ThoMint/modFOC/README.md

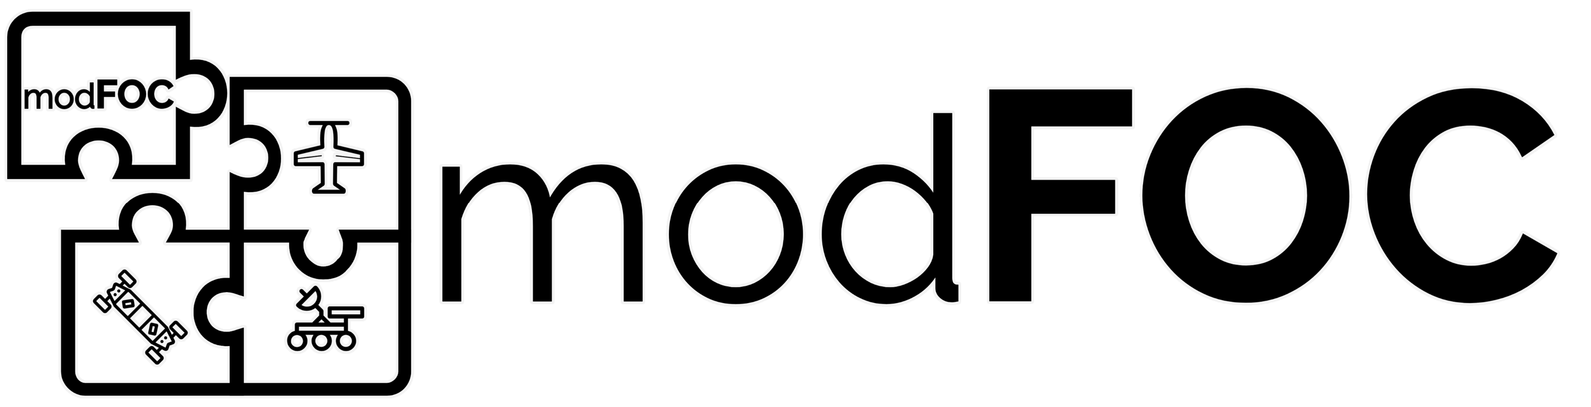
[picture p1: PR/modFOC-Logo-Landscape-Outline.png]
modFOC
# 
A modular ESC with in Hardware implemented FOC for maximum efficiency.<br>
The ESC is designed as a PCB-Stackup with various Powerstages and a central Control-Board:

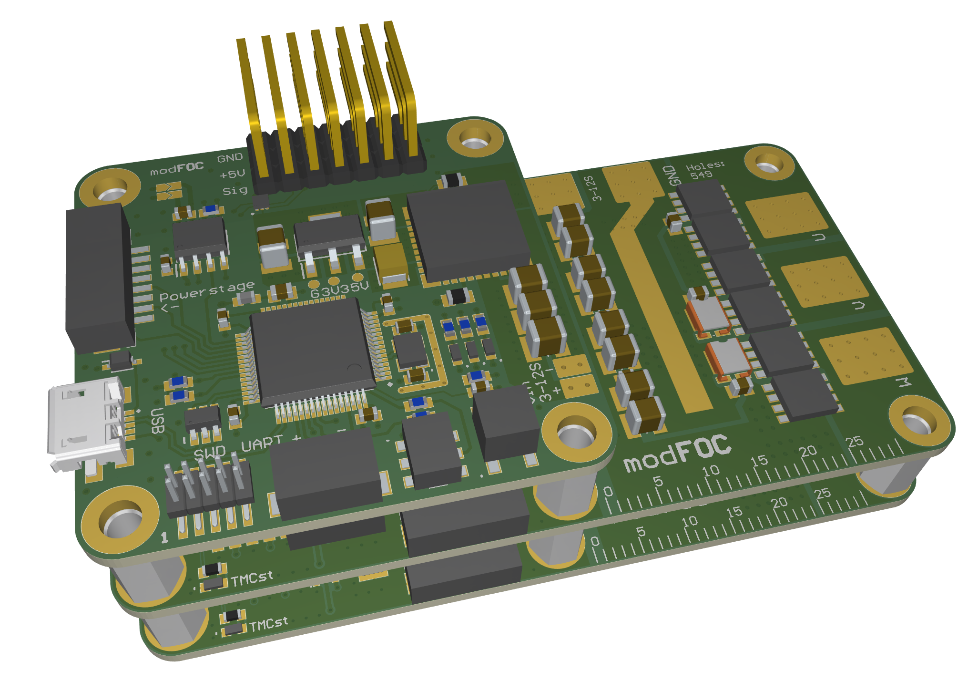
[picture p2: PR/MBA-3D-Render.png]
modFOC Render


As this Project advances, more and more Powerstages will be available supporting a variaty of Motors:
 - BLDC
 - Stepper
 - DC
