ThoMint/modFOC/DesignGuide/TMC4671Eval/BOM/BOM_TMC4671-EVAL_V1.2.xls

Sheet: Part List Report
 | BOM |  | BOM for Project [TMC4671-EVAL_V1_2.PrjPcb] (No PCB Document Selected)
 | Project: | TMC4671-EVAL
 | Version: | 1.2
 | Date: | 2019-09-04
# | Quantity | MPN | Comment | Designator | FootPrint | Description | Note | MF
1 | 14 | MC0603B104K100CT | 100nF/10V | C200, C201, C320, C321, C322, C323, C601, C602, C604, C605, C606, C607, C608, C610 | C0603 | SMD Multilayer Ceramic Capacitor, 0603 [1608 Metric], 0.1 µF, 10 V, ± 10%, X7R, MC Series |  | Multicomp
2 | 5 | MC0603X105K100CT | 1uF/10V | C300, C301, C302, C303, C500 | C0603 | SMD Multilayer Ceramic Capacitor, 0603 [1608 Metric], 1 µF, 10 V, ± 10%, X5R, MC Series |  | MULTICOMP
3 | 11 | MC0603N101J500CT | 100pF/50V/5% | C304, C305, C306, C307, C308, C309, C501, C502, C503, C504, C505 | C0603 | SMD Multilayer Ceramic Capacitor, 0603 [1608 Metric], 100 pF, 50 V, ± 5%, C0G / NP0, MC Series |  | MULTICOMP
4 | 6 | MC0603B102K250CT | 1nF/25V | C310, C311, C314, C315, C318, C319 | C0603 | SMD Multilayer Ceramic Capacitor, 0603 [1608 Metric], 1000 pF, 25 V, ± 10%, X7R, MC Series |  | MULTICOMP
5 | 2 | MCMT18N101F100CT | 100pF/10V | C506, C507 | C0603 | SMD Multilayer Ceramic Capacitor, 0603 [1608 Metric], 100 pF, 10 V, ± 1%, C0G / NP0, MCMT Series |  | MULTICOMP
6 | 1 | MCSH18B103K100CT | 10nF | C508 | C0603 | SMD Multilayer Ceramic Capacitor, 0603 [1608 Metric], 0.01 µF, 10 V, ± 10%, X7R, MCSH Series |  | MULTICOMP
7 | 1 | EMK325ABJ107MM-T | 100uF/16V | C600 | C1210 | SMD Multilayer Ceramic Capacitor, 1210 [3225 Metric], 100 µF, 16 V, ± 20%, X5R, M Series |  | TAIYO YUDEN
8 | 2 | MC0603X475K100CT | 4u7/10V | C603, C609 | C0603 | SMD Multilayer Ceramic Capacitor, 0603 [1608 Metric], 4.7 µF, 10 V, ± 10%, X5R, MC Series |  | MULTICOMP
9 | 1 | GRM31CR60J107ME39L. | 100uF/6V3 | C611 | C1210 | SMD Multilayer Ceramic Capacitor, 1210 [3225 Metric], 100 µF, 6.3 V, ± 20%, X5R, GRM Series |  | MURATA
10 | 1 | GRM31CR61A476ME15L | 47uF/10V | C612 | C1206 | SMD Multilayer Ceramic Capacitor, 1206 [3216 Metric], 47 µF, 10 V, ± 20%, X5R, GRM Series |  | MURATA
11 | 1 | MC0603B104K100CT | 100nF | C613 | C0603 | SMD Multilayer Ceramic Capacitor, 0603 [1608 Metric], 0.1 µF, 10 V, ± 10%, X7R, MC Series |  | Multicomp
12 | 1 | MC0603X474K160CT | 470nF | C614 | C0603 | SMD Multilayer Ceramic Capacitor, 0603 [1608 Metric], 0.47 µF, 16 V, ± 10%, X5R, MC Series |  | Multicomp
13 | 1 | MC0603X475K100CT | 4u7 | C615 | C0603 | SMD Multilayer Ceramic Capacitor, 0603 [1608 Metric], 4.7 µF, 10 V, ± 10%, X5R, MC Series |  | MULTICOMP
14 | 7 | BAT54S | BAT54S | D200, D500, D501, D502, D503, D504, D505 | SOT95P237X130-3N | Small Signal Schottky Diode, Dual Series, 30 V, 200 mA, 1 V, 600 mA, 125 °C |  | TAIWAN SEMICONDUCTOR
15 | 1 | TMC4671 | TMC4671 | IC200 | QFN40P1050X650X90_HS-77N |  |  | TRINAMIC
16 | 1 | AT25128B-SSHL-T | AT25128B-SSHL-T | IC201 | SOP127P600X175-8N | EEPROM, SPI, 128 Kbit, 16K x 8bit, 20 MHz, SOIC, 8 Pins |  | MICROCHIP
17 | 4 | SN74LVC3G17DCUR | SN74LVC3G17DCUR | IC300, IC301, IC302, IC303 | TSSOP50P310X90-8L | Triple Schmitt-Trigger Buffer, 74LVC3G17, 1.65 V to 5.5 V, VSSOP-8 |  | TEXAS INSTRUMENTS
18 | 1 | LD1117S33CTR | LD1117S33CTR | IC600 | SOT230P700X180-4N | Fixed LDO Voltage Regulator, 4.75V to 15V, 1.1V Dropout, 3.3Vout, 950mAout, SOT-223-4 |  | STMICROELECTRONICS
19 | 1 | MFB-160808-0030PQ | 30R | L200 | L0603 | Ferrite Bead, 30 ohm, 0603 [1608 Metric], MFB Series, 3 A, 0.04 ohm, ± 25% |  | MEC MARCOM
20 | 2 | 46-3492-44-3-00-10-PPTR | Interface to UC/MC | P1, P2 | Interface_Connector | Board-To-Board Connector, 2.54 mm, 44 Contacts, Receptacle, HLE Series, Surface Mount, 2 Rows |  | W+P
21 | 1 |  | UART | P200 | TH_HDR_1X3 | Header, 3-Pin | Not fitted
22 | 1 | DF20F-10DP-1V(56) | DF20F-10DP-1V(56) | P201 | CON, TMC Debug SPI | Wire-To-Board Connector, 1 mm, 10 Contacts, Header, DF20 Series, Surface Mount, 2 Rows |  | Hirose Electric Co Ltd
23 | 1 |  | PWM_IN | P202 | TH_HDR_1X2 | Header, 2-Pin | Not fitted
24 | 1 |  | ENC1 | P300 | TH_HDR_1X5 | Header, 5-Pin
25 | 1 |  | ENC2 | P301 | TH_HDR_1X5 | Header, 5-Pin
26 | 1 |  | HALL | P302 | TH_HDR_1X5 | Header, 5-Pin
27 | 1 |  | REF_SW | P303 | TH_HDR_1X5 | Header, 5-Pin
28 | 1 |  | BRAKE_OUT | P400 | TH_HDR_1X2 | Header, 2-Pin
29 | 1 |  | AENC | P500 | TH_HDR_1X5 | Header, 5-Pin
30 | 1 |  | AIN_B | P501 | TH_HDR_1X2 | Header, 2-Pin
31 | 1 |  | AIN_A | P502 | TH_HDR_1X2 | Header, 2-Pin
32 | 11 | MC0063W0603110K | 10k | R200, R400, R401, R402, R403, R404, R405, R407, R408, R409, R410 | R0603 | SMD Chip Resistor, Thick Film, 10 kohm, 50 V, 0603 [1608 Metric], 63 mW, ± 1%, MC Series |  | MULTICOMP
33 | 8 | MCWR06X1001FTL, MC0063W060311K | 1k | R300, R301, R302, R303, R304, R305, R507, R508 | R0603 | SMD Chip Resistor, Thick Film, 1 kohm, 50 V, 0603 [1608 Metric], 100 mW, ± 1%, MCWR Series, SMD Chip Resistor, Thick Film, 1 kohm, 50 V, 0603 [1608 Metric], 100 mW, ± 0.5%, RE Series |  | MULTICOMP
34 | 18 | WR06X4701FTL | 4k7 | R306, R307, R308, R309, R310, R311, R312, R313, R314, R315, R316, R317, R318, R319, R320, R321, R322, R323 | R0603 | SMD Chip Resistor, 4.7 kohm, 75 V, 0603 [1608 Metric], 100 mW, ± 1%, WR06 Series |  | WALSIN
35 | 1 | MC0063W0603110K | 10R | R406 | R0603 | SMD Chip Resistor, Thick Film, 10 ohm, 50 V, 0603 [1608 Metric], 100 mW, ± 1%, MCWR Series |  | MULTICOMP
36 | 5 | MCWR06X1000FTL | 100R | R500, R501, R502, R503, R504 | R0603 | SMD Chip Resistor, Thick Film, 100 ohm, 50 V, 0603 [1608 Metric], 100 mW, ± 1%, MCWR Series |  | MULTICOMP
37 | 2 | CRCW08054K00FKTA | 4k | R505, R506 | R0805 | SMD Chip Resistor, Thick Film, 4 kohm, 150 V, 0805 [2012 Metric], 125 mW, ± 1%, CRCW Series |  | VISHAY
38 | 1 | MCWR06X1501FTL | 1k5 | R509 | R0603 | SMD Chip Resistor, Thick Film, 1.5 kohm, 50 V, 0603 [1608 Metric], 100 mW, ± 1%, MCWR Series |  | MULTICOMP
39 | 1 | MCWR06X1003FTL | 100k | R510 | R0603 | SMD Chip Resistor, Thick Film, 100 kohm, 50 V, 0603 [1608 Metric], 100 mW, ± 1%, MCWR Series |  | MULTICOMP
40 | 1 | FOX924B-25.000 | 25MHz | XTL200 | FOX924B-25.000 | TCXO, 25 MHz, 2.5 ppm, SMD, 5mm x 3.2mm, HCMOS, 3.3 V, FOX924 Series |  | FOX ELECTRONICS
Approved |  |  | Notes |  |  |  |  | 123

Sheet: Project Information
Project Full Path | C:\Users\UK\AppData\Local\TempReleases\Snapshot\10\TMC4671-EVAL_V1_2.PrjPcb
Project Filename | TMC4671-EVAL_V1_2.PrjPcb
Variant Name | None
Data-Source Filename | TMC4671-EVAL_V1_2.PrjPcb
Data-Source Full Path | C:\Users\UK\AppData\Local\TempReleases\Snapshot\10\TMC4671-EVAL_V1_2.PrjPcb
Title | BOM for Project [TMC4671-EVAL_V1_2.PrjPcb] (No PCB Document Selected)
Total Quantity | 123
Report Time | 15:44:00
Report Date | 2019-09-04
Report Date & Tine | 2019-09-04 15:44
Output Name | BOM
Output Type | BOM_PartType
Output Generator Name | BOM
Output Generator Description | Bill of Materials
