ThoMint/modFOC/DesignGuide/AlternatePartsModFOC.xlsx

Original Part Nr | Alternative Part Nr
TPH2R506PL | 757-TPH2R306NHL1Q
LB Q39G-L2OO-35-1 | LB Q39E-N1OO-35-1
CL32B106KMVNNWE | C3225X7R1N106M250AC
LS L29K-G1J2-1-Z | 150060RS75000
BAT54S | BAT54S-HF
CAS-D20A1 | Home-Stock
ERJ-6ENF4992V | CRCW080549K9FKEAC
MCT06030C1002FP500 | RT0603FRE0710KL (https://www.mouser.at/ProductDetail/Yageo/RT0603FRE0710KL?qs=8cPjvKtxWv43uywOotU9ew%3D%3D)
STM32G474RBT6 | Digikey
LG Q396-PS-35 | 150060GS75000 (https://www.mouser.at/ProductDetail/Wurth-Elektronik/150060GS75000?qs=LlUlMxKIyB0UYkq5lDO8nA%3D%3D)
AP2114H-3.3TRG1 | AP7361-33E-13 (https://www.mouser.at/ProductDetail/Diodes-Incorporated/AP7361-33E-13?qs=gfe7vQ8txpWtbSNeblwOwA%3D%3D)
BAS3010A03WE6327HTSA1 | CUS10S30,H3F (https://www.mouser.at/ProductDetail/Toshiba/CUS10S30H3F?qs=cW4DzVrAanO4Xm6ySrHr7g%3D%3D)
