ThoMint/modFOC/Hardware/modFOC-ESC/Project Outputs for modFOC/modFOC_BOM.xlsx

Quantity | Manufacturer_Part_Number | Mouser Part Number | Manufacturer_Name | Designator
1 | CL32B106KMVNNWE | 187-CL32B106KMVNNWE | Samsung Electro-Mechanics | C100
1 | CL32B106KMVNNWE | 187-CL32B106KMVNNWE | Samsung Electro-Mechanics | C101
1 | CL32B106KMVNNWE | 187-CL32B106KMVNNWE | Samsung Electro-Mechanics | C102
1 | VJ0603Y104JXJAC | 77-VJ0603Y104JXJAC | Vishay | C103
1 | VJ0603Y104JXJAC | 77-VJ0603Y104JXJAC | Vishay | C104
1 | VJ0603Y104JXJAC | 77-VJ0603Y104JXJAC | Vishay | C105
1 | VJ0603Y104JXJAC | 77-VJ0603Y104JXJAC | Vishay | C106
1 | VJ0603Y104JXJAC | 77-VJ0603Y104JXJAC | Vishay | C107
1 | VJ0603Y104JXJAC | 77-VJ0603Y104JXJAC | Vishay | C108
1 | VJ0603Y104JXJAC | 77-VJ0603Y104JXJAC | Vishay | C109
1 | VJ0603Y104JXJAC | 77-VJ0603Y104JXJAC | Vishay | C110
1 | VJ0603Y104JXJAC | 77-VJ0603Y104JXJAC | Vishay | C111
1 | CL32B106KMVNNWE | 187-CL32B106KMVNNWE | Samsung Electro-Mechanics | C112
1 | 08051C474KAT2A | 581-08051C474KAT2A | AVX | C113
1 | CL32B106KMVNNWE | 187-CL32B106KMVNNWE | Samsung Electro-Mechanics | C114
1 | VJ0603Y104JXJAC | 77-VJ0603Y104JXJAC | Vishay | C115
1 | VJ0603Y104JXJAC | 77-VJ0603Y104JXJAC | Vishay | C200
1 | GRM033R71E102KA01D | 81-GRM033R71E102KA1D | Murata Electronics | C201
1 | GRM033R71E102KA01D | 81-GRM033R71E102KA1D | Murata Electronics | C202
1 | GRM033R71E102KA01D | 81-GRM033R71E102KA1D | Murata Electronics | C203
1 | VJ0603Y104JXJAC | 77-VJ0603Y104JXJAC | Vishay | C205
1 | CL32B106KMVNNWE | 187-CL32B106KMVNNWE | Samsung Electro-Mechanics | C300
1 | CGA3E2X7R1H473K080AA | 810-CGA3E2X7R1H473K | TDK | C304
1 | CL32B106KMVNNWE | 187-CL32B106KMVNNWE | Samsung Electro-Mechanics | C305
1 | CL32B106KMVNNWE | 187-CL32B106KMVNNWE | Samsung Electro-Mechanics | C306
1 | VJ0603Y104JXJAC | 77-VJ0603Y104JXJAC | Vishay | C307
1 | VJ0603Y104JXJAC | 77-VJ0603Y104JXJAC | Vishay | C308
1 | CL32B106KMVNNWE | 187-CL32B106KMVNNWE | Samsung Electro-Mechanics | C309
1 | CL32B106KMVNNWE | 187-CL32B106KMVNNWE | Samsung Electro-Mechanics | C310
1 | CL32B106KMVNNWE | 187-CL32B106KMVNNWE | Samsung Electro-Mechanics | C?
1 | VJ0603Y104JXJAC | 77-VJ0603Y104JXJAC | Vishay | C?
1 | C0603C101K1HACTU | 80-C0603C101K1HACTU | Kemet | C?
1 | C0603C101K1HACTU | 80-C0603C101K1HACTU | Kemet | C?
1 | C0603C101K1HACTU | 80-C0603C101K1HACTU | Kemet | C?
1 | 08051C474KAT2A | 581-08051C474KAT2A | AVX | C?
1 | 08051C474KAT2A | 581-08051C474KAT2A | AVX | C?
1 | 08051C474KAT2A | 581-08051C474KAT2A | AVX | C?
1 | DF13A-8P-1.25H(21) | 798-DF13A8P125H21 | Hirose | CON101
1 | DF13A-4P-1.25H(51) | 798-DF13A4P125H51 | Hirose | CON102
1 | BAT54S | 583-BAT54S | Rectron | D200
1 | 74LVC138ABQ,115 | 771-LVC138ABQ115 | Nexperia | IC102
1 | AP2114H-3.3TRG1 | 621-AP2114H-3.3TRG1 | Diodes Inc. | IC103
1 | 74LVC3G17DP,125 | 771-LVC3G17DP125 | Nexperia | IC200
1 | DRV8323HRTAR | 595-DRV8323HRTAR | Texas Instruments | IC300
1 |  |  |  | IC 101
1 | DF13A-5P-1.25H(21) | 798-DF13A5P125H21 | Hirose | J200
1 |  |  |  | JP1
1 |  |  |  | JP2
1 |  |  |  | JP3
1 |  |  |  | JP4
1 |  |  |  | JP5
1 |  |  |  | JP6
1 |  |  |  | JP7
1 |  |  |  | JP8
1 | BLM18KG300TH1D | 81-BLM18KG300TH1D | Murata Electronics | L101
1 | ASMT-RA45-AP932 | 630-ASMT-RA45-AP932 | Avago Technologies | LED200
1 | LB Q39G-L2OO-35-1 | 720-LBQ39GL2N2351 | OSRAM | LED201
1 | LG Q396-PS-35 | 720-LGQ396A3964 | OSRAM | LED202
1 | LS L29K-G1J2-1-Z | 720-LSL29K-G1J2-1-Z | OSRAM | LED300
1 | TPH2R506PL,L1Q | 757-TPH2R506PLL1Q | Toshiba | Q300
1 | TPH2R506PL,L1Q | 757-TPH2R506PLL1Q | Toshiba | Q301
1 | TPH2R506PL,L1Q | 757-TPH2R506PLL1Q | Toshiba | Q302
1 | TPH2R506PL,L1Q | 757-TPH2R506PLL1Q | Toshiba | Q303
1 | TPH2R506PL,L1Q | 757-TPH2R506PLL1Q | Toshiba | Q304
1 | TPH2R506PL,L1Q | 757-TPH2R506PLL1Q | Toshiba | Q305
1 | RC0603FR-0710KL | 603-RC0603FR-0710KL | YAGEO (PHYCOMP) | R100
1 | RC0603FR-0710KL | 603-RC0603FR-0710KL | YAGEO (PHYCOMP) | R101
1 | CRCW0603100RFKEAC | 71-CRCW0603100RFKEAC | Vishay | R102
1 | CRCW06034K70JNEAC | 71-CRCW06034K70JNEAC | Vishay | R200
1 | CRCW06034K70JNEAC | 71-CRCW06034K70JNEAC | Vishay | R201
1 | CRCW06034K70JNEAC | 71-CRCW06034K70JNEAC | Vishay | R202
1 | SFR03EZPF1500 | 755-SFR03EZPF1500 | ROHM Semiconductor | R203
1 | CRCW0603100RFKEAC | 71-CRCW0603100RFKEAC | Vishay | R204
1 | CR0603-FX-47R0ELF | 652-CR0603FX-47R0ELF | Bourns | R205
1 | CRCW06034K70JNEAC | 71-CRCW06034K70JNEAC | Vishay | R206
1 | CRCW06034K70JNEAC | 71-CRCW06034K70JNEAC | Vishay | R207
1 | CRCW06034K70JNEAC | 71-CRCW06034K70JNEAC | Vishay | R208
1 | CRCW0603100RFKEAC | 71-CRCW0603100RFKEAC | Vishay | R209
1 | RC0603FR-0710KL | 603-RC0603FR-0710KL | YAGEO (PHYCOMP) | R210
1 | RC0603FR-0710KL | 603-RC0603FR-0710KL | YAGEO (PHYCOMP) | R211
1 | ERJ1GNF1003C |  | Panasonic | R212
1 | ERJ1GNF1501C |  | Panasonic | R213
1 | CRCW0603100RFKEAC | 71-CRCW0603100RFKEAC | Vishay | R214
1 | RC0603FR-0710KL | 603-RC0603FR-0710KL | YAGEO (PHYCOMP) | R215
1 | RC0603FR-0710KL | 603-RC0603FR-0710KL | YAGEO (PHYCOMP) | R216
1 | RC0603FR-071ML | 603-RC0603FR-071ML | YAGEO (PHYCOMP) | R300
1 | RC0603FR-0710KL | 603-RC0603FR-0710KL | YAGEO (PHYCOMP) | R303
1 | RC0603FR-0710KL | 603-RC0603FR-0710KL | YAGEO (PHYCOMP) | R304
1 | CRCW0603100RFKEAC | 71-CRCW0603100RFKEAC | Vishay | R305
1 | CRCW0603100RFKEAC | 71-CRCW0603100RFKEAC | Vishay | R306
1 | RC0603FR-10470RL | 603-RC0603FR-10470RL | YAGEO (PHYCOMP) | R307
1 | WSK1216L5000FEA |  | Vishay | R?
1 | WSK1216L5000FEA |  | Vishay | R?
1 | LL3301AF065QJ | 612-LL3301AF065QJ | E-Switch | SW101
1 | LL3301AF065QJ | 612-LL3301AF065QJ | E-Switch | SW300
1 | LL3301AF065QJ | 612-LL3301AF065QJ | E-Switch | SW301
1 |  |  |  | XTL101
