ThoMint/modFOC/(threads)

Thread 1 (2021-09-19):

it can support PMSM?

Alvazz, 2021-09-19:
Hi,
this FOC controller, it can support PMSM motor or not?

ThoMint, 2021-09-20:
Hello,
Yes it can however i would recommend to wait for the next revision if your planning on building this Motion Controller yourself.
Next Version will also support Stepper and other encoder types. There will also be a configuration desktop app.

Alvazz, 2021-09-20:
Thank you for your reply, I look forward to it

Closed 2021-09-20.

Thread 2 (2021-09-27):

Every day I will visit your warehouse to see if there is progress and updates.

Alvazz, 2021-09-27:
Hi ThoMint，Every day I will visit your warehouse to see if there is progress and updates. I think your project has unlimited potential and is pretty good in all aspects. I think I might also be able to do something for the project, if you are too busy. I know C, C++, AD, and I hope to help the project move forward more quickly. In addition, I would like to consult, why would you consider the combination of TMC4671 and TMC6100? I mean, have you ever considered DRV8301?

ThoMint, 2021-09-27:
Hi Alvazz.
We are happy to hear that our project finds some interest in the community. We are working in a team of 2. Since this is a school project for now, we can not accept your very kind offer of helping us out. The gate driver TMC6100 looks appealing at first but ultimately has poor drive current, needs an additional SPI channel and is rather expensive. DRV8301 is very big and has less features than our current choice of Gate Drivers. Next version will use single gate drivers allowing for more customizability like supporting bldc + stepper motors and being more power efficient. The next version will be available in a few months.

Alvazz, 2021-09-27:
OK, get it.
"The gate driver TMC6100 looks appealing at first but ultimately has poor drive current, needs an additional SPI channel and is rather expensive."  this is a sad thing.

What about the TMC6200 and TMC4671? I have never used it, so I hope you can give some suggestions so as not to be disappointed again!

Alvazz, 2021-09-27:
What about LM5109B? Does it look good? But it seems that it has been discontinued?

ThoMint, 2021-09-27:
LM5109B has a big footprint, weak drive current and needs an additional Bootstrap Diode. For v2.0 we settled on TIs UCC27282 Series in the VSON Package.

Alvazz, 2021-09-27:
I'm looking forward to v2.0 too much. Can I launch it faster? I can't wait, hahaha

Alvazz, 2021-09-27:
Aha, I suddenly want to have more communication with you, but after all, GitHub is more related to modfoc. Come on, send me an email, and we can communicate more immediately jasonzzpro@gmail.com

Thread 3 (2022-07-20):

Let's get in contact :)

quintenadema, 2022-07-20:
Hi there,

My name is Quinten and my company (based in The Netherlands) does work for several light-EV manufacturers (mostly e-bikes). We're currently looking into designing our own ESC and I want to ask if you are interested in helping us with this new project - would be cool to base it off of the current modFOC as it looks really good. Of course you will get paid for your work :)

Please contact me at quinten@ademagroup.com if you're interested, or would just like to talk. Would be cool to set up a meeting to get to know each other!

PS: sorry for using the issue channel for this but I couldn't find another way to contact you guys.

Closed 2022-07-24.
