ThoMint/modFOC/DesignGuide/TMC4671Eval/PDF/Fabrication_info_TMC4671-EVAL_V1.2.PDF

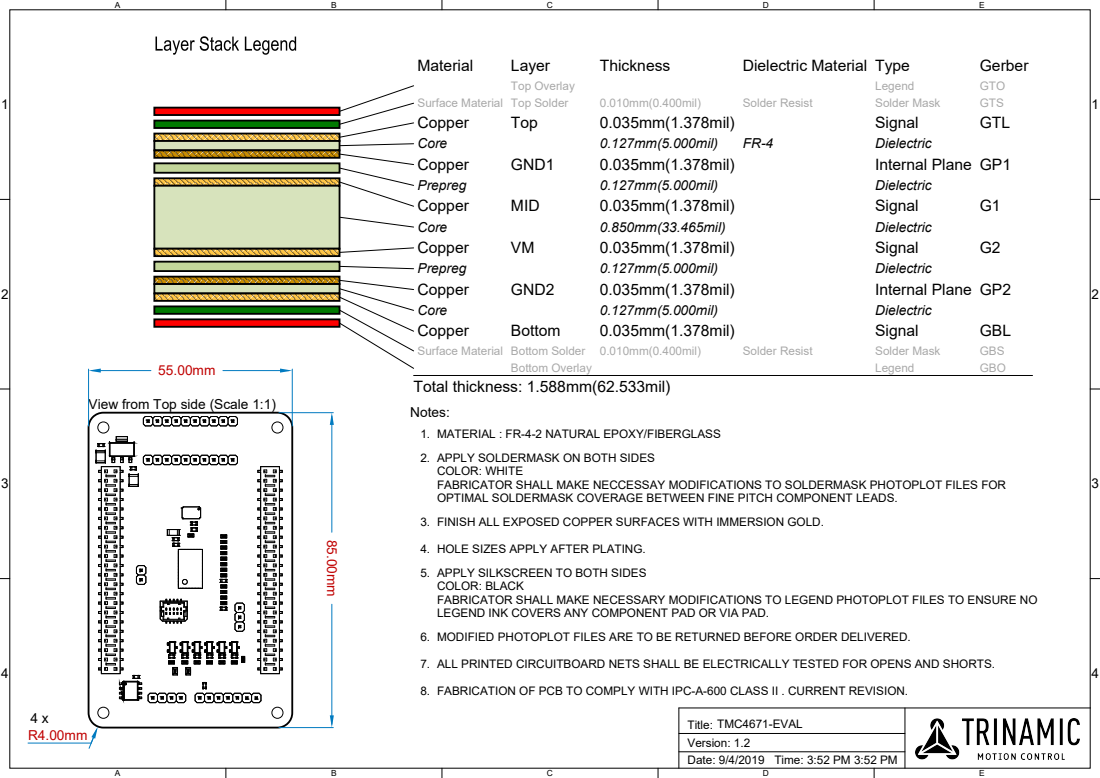
[picture p17: page 1]

Total thickness: 1.588mm(62.533mil)
Notes:
1. MATERIAL : FR-4-2 NATURAL EPOXY/FIBERGLASS
APPLY SOLDERMASK ON BOTH SIDES
COLOR: WHITE
FABRICATOR SHALL MAKE NECCESSAY MODIFICATIONS TO SOLDERMASK PHOTOPLOT FILES FOR
OPTIMAL SOLDERMASK COVERAGE BETWEEN FINE PITCH COMPONENT LEADS.
3. FINISH ALL EXPOSED COPPER SURFACES WITH IMMERSION GOLD.

View from Top side (Scale 1:1)

4. HOLE SIZES APPLY AFTER PLATING.
APPLY SILKSCREEN TO BOTH SIDES
COLOR: BLACK
FABRICATOR SHALL MAKE NECESSARY MODIFICATIONS TO LEGEND PHOTOPLOT FILES TO ENSURE NO
LEGEND INK COVERS ANY COMPONENT PAD OR VIA PAD.
6. MODIFIED PHOTOPLOT FILES ARE TO BE RETURNED BEFORE ORDER DELIVERED.

7. ALL PRINTED CIRCUITBOARD NETS SHALL BE ELECTRICALLY TESTED FOR OPENS AND SHORTS.

8. FABRICATION OF PCB TO COMPLY WITH IPC-A-600 CLASS II . CURRENT REVISION.

Title: TMC4671-EVAL
Version: 1.2
Date: 9/4/2019 Time: 3:52 PM 3:52 PM
