ThoMint/modFOC/DesignGuide/TMC4671Bob/FABRICATION/TMC4671+TMC6100-BOB_V10 - Component Placement.pdf

TMC4671+TMC6100-BOB_V1.0 | 500% | Component Placement Drawing J202 J201 | J204 J206 J205 J203 | X³⁰¹

## IC301 J202

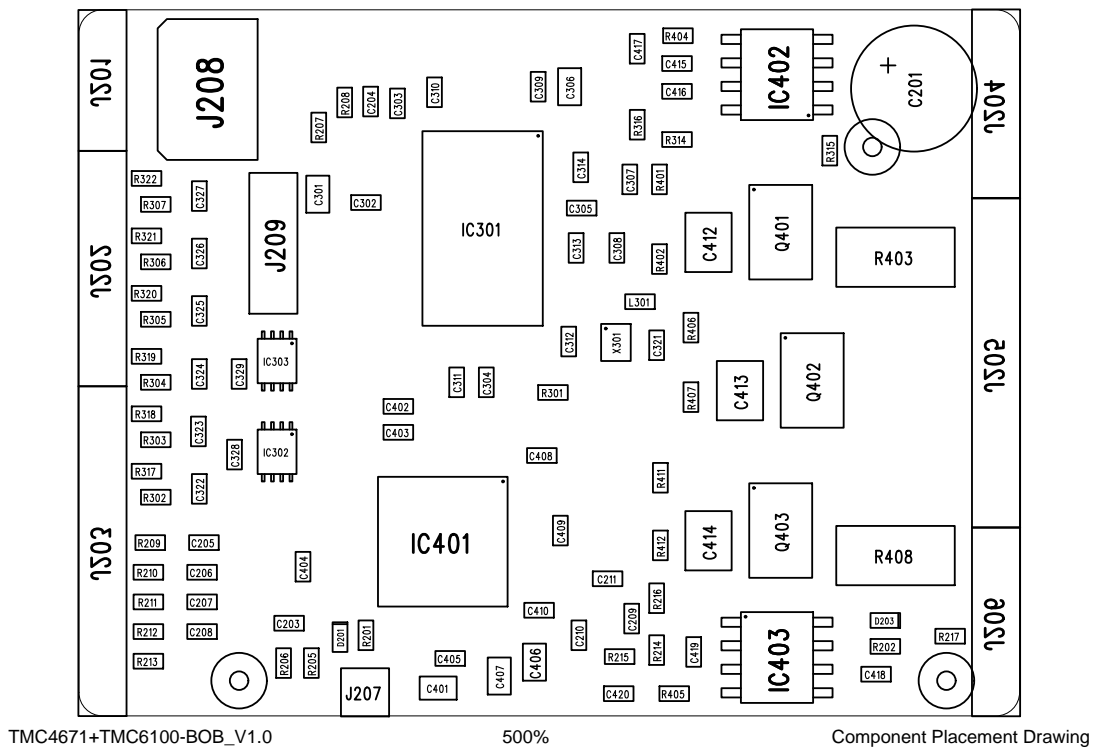
[picture p18: page 1]

TMC4671+TMC6100-BOB_V1.0 | 500% | Component Placement Drawing J202 J201 J204 J206 J205 | J203

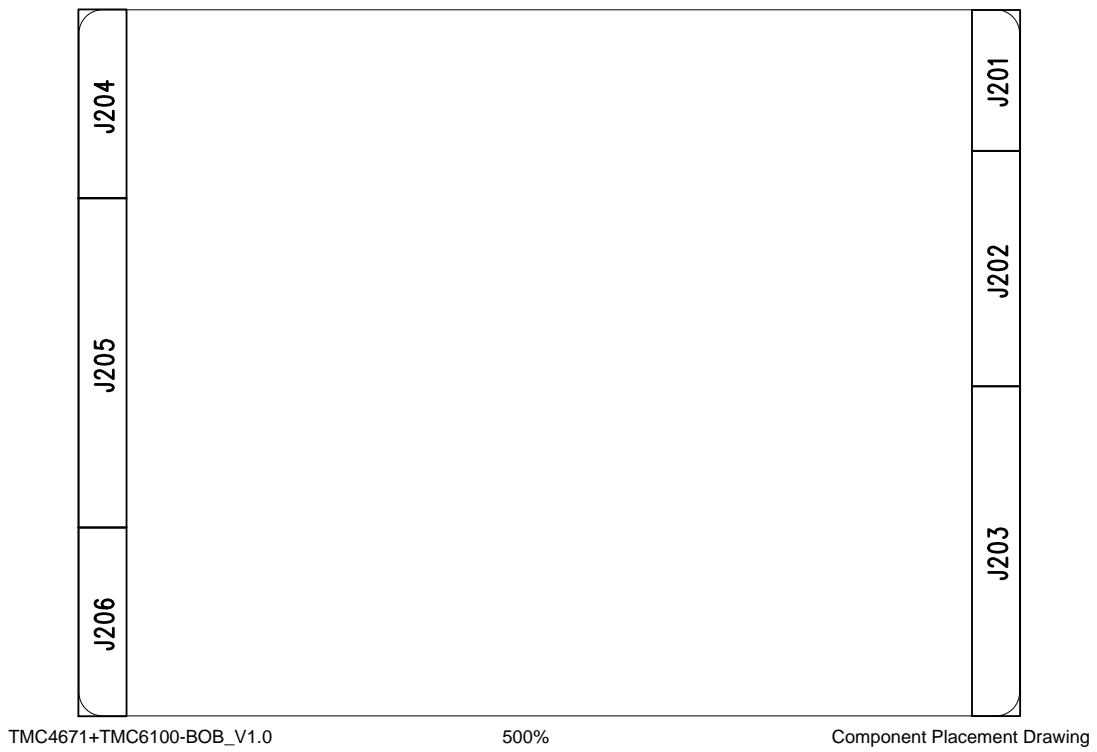
[picture p19: page 2]
