ThoMint/modFOC/DesignGuide/TMC4671Eval/PDF/Assembly_drawing_TMC4671-EVAL_V1.2.PDF

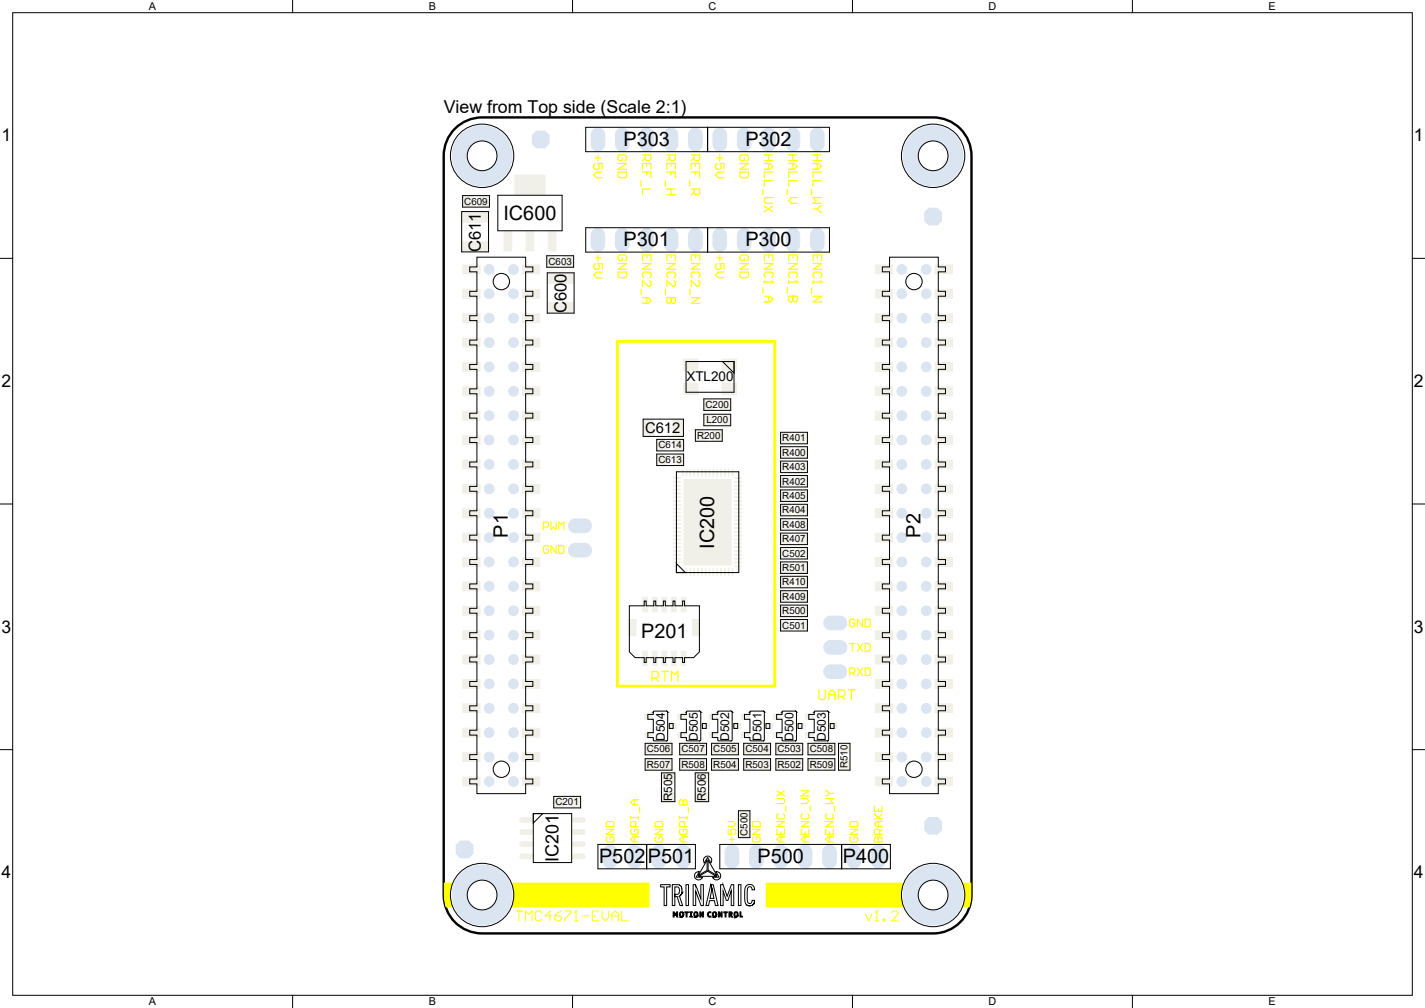
[picture p20: page 1]

View from Top side (Scale 2:1)

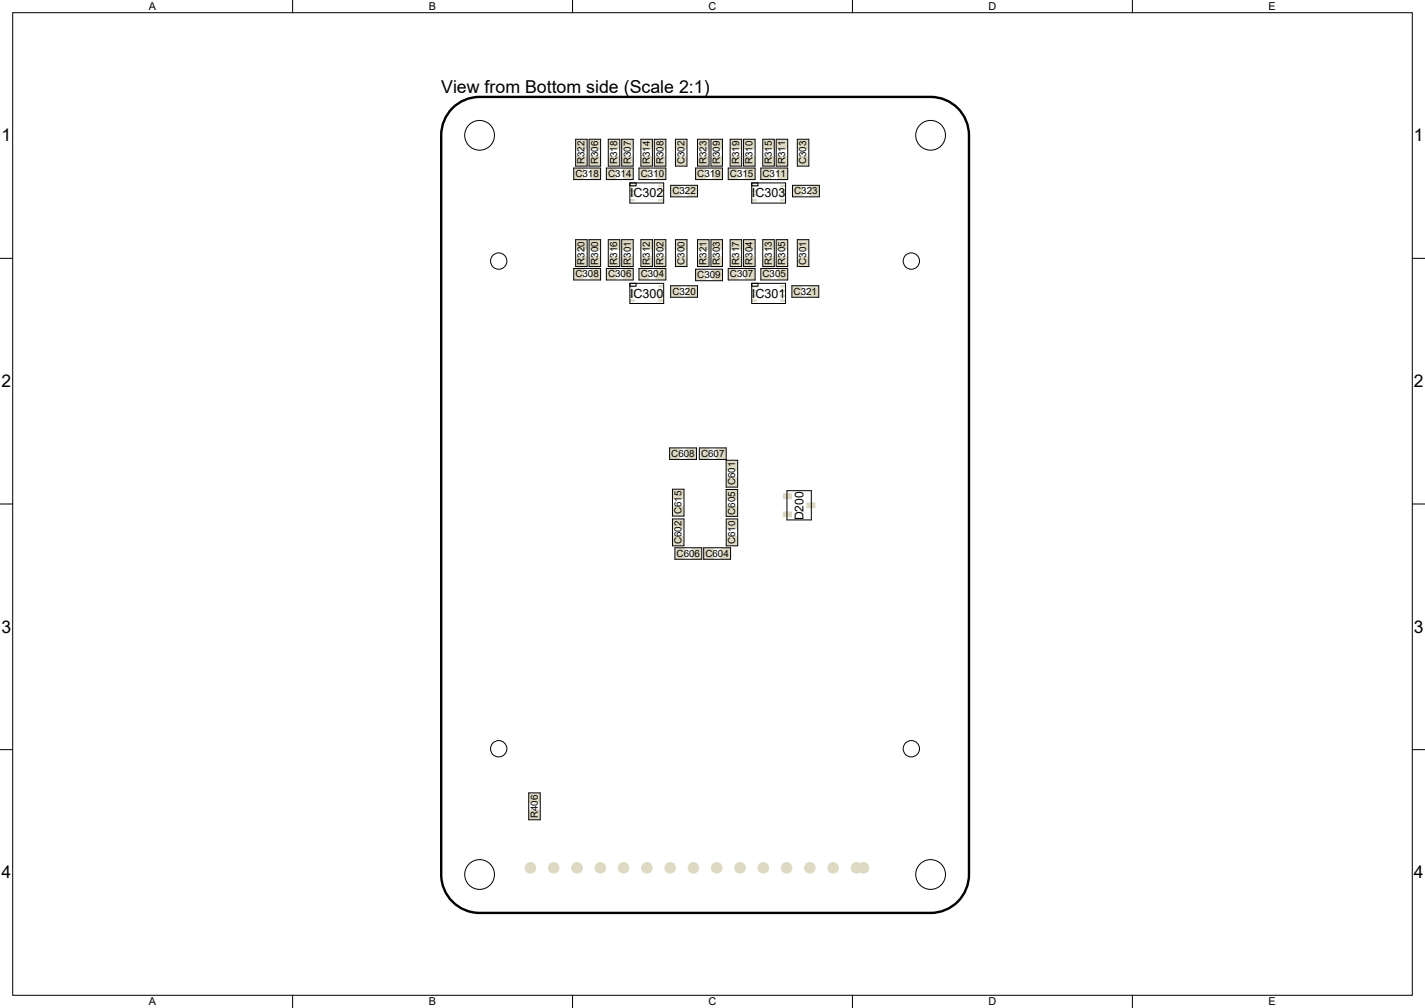
[picture p21: page 2]

View from Bottom side (Scale 2:1)

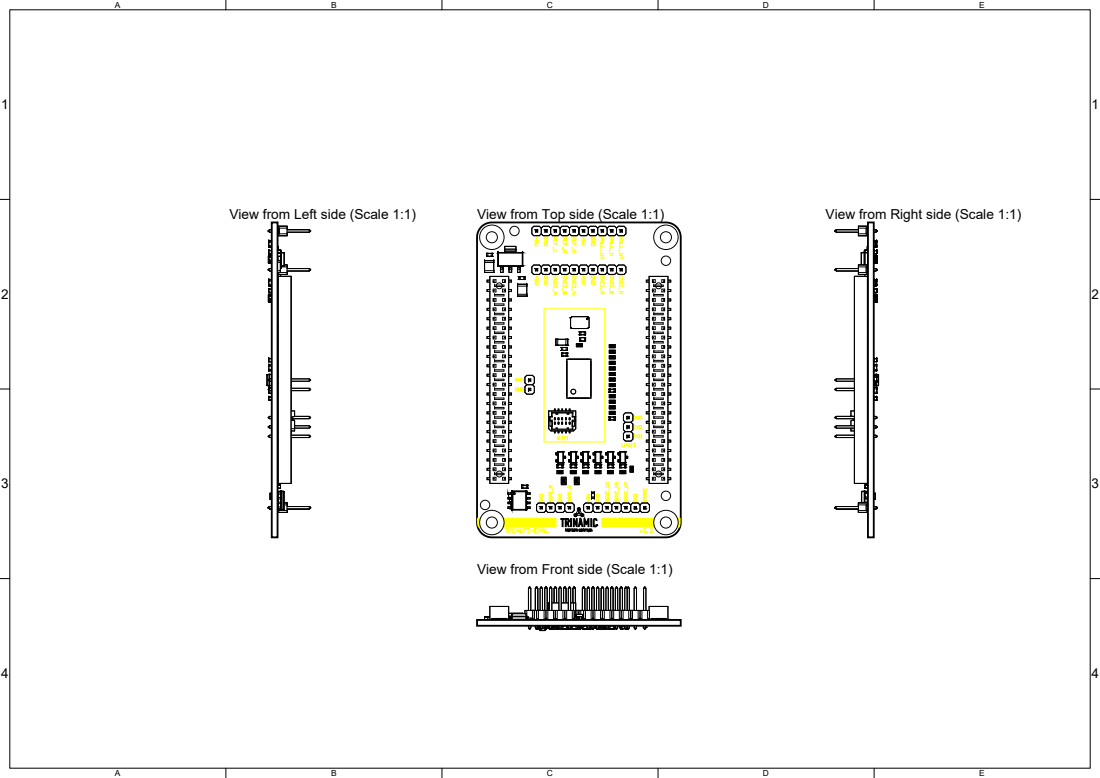
[picture p22: page 3]

View from Top side (Scale 1:1)

View from Front side (Scale 1:1)
