ThoMint/modFOC/DesignGuide/TMC4671Bob/PDF/Layers/L1.pdf

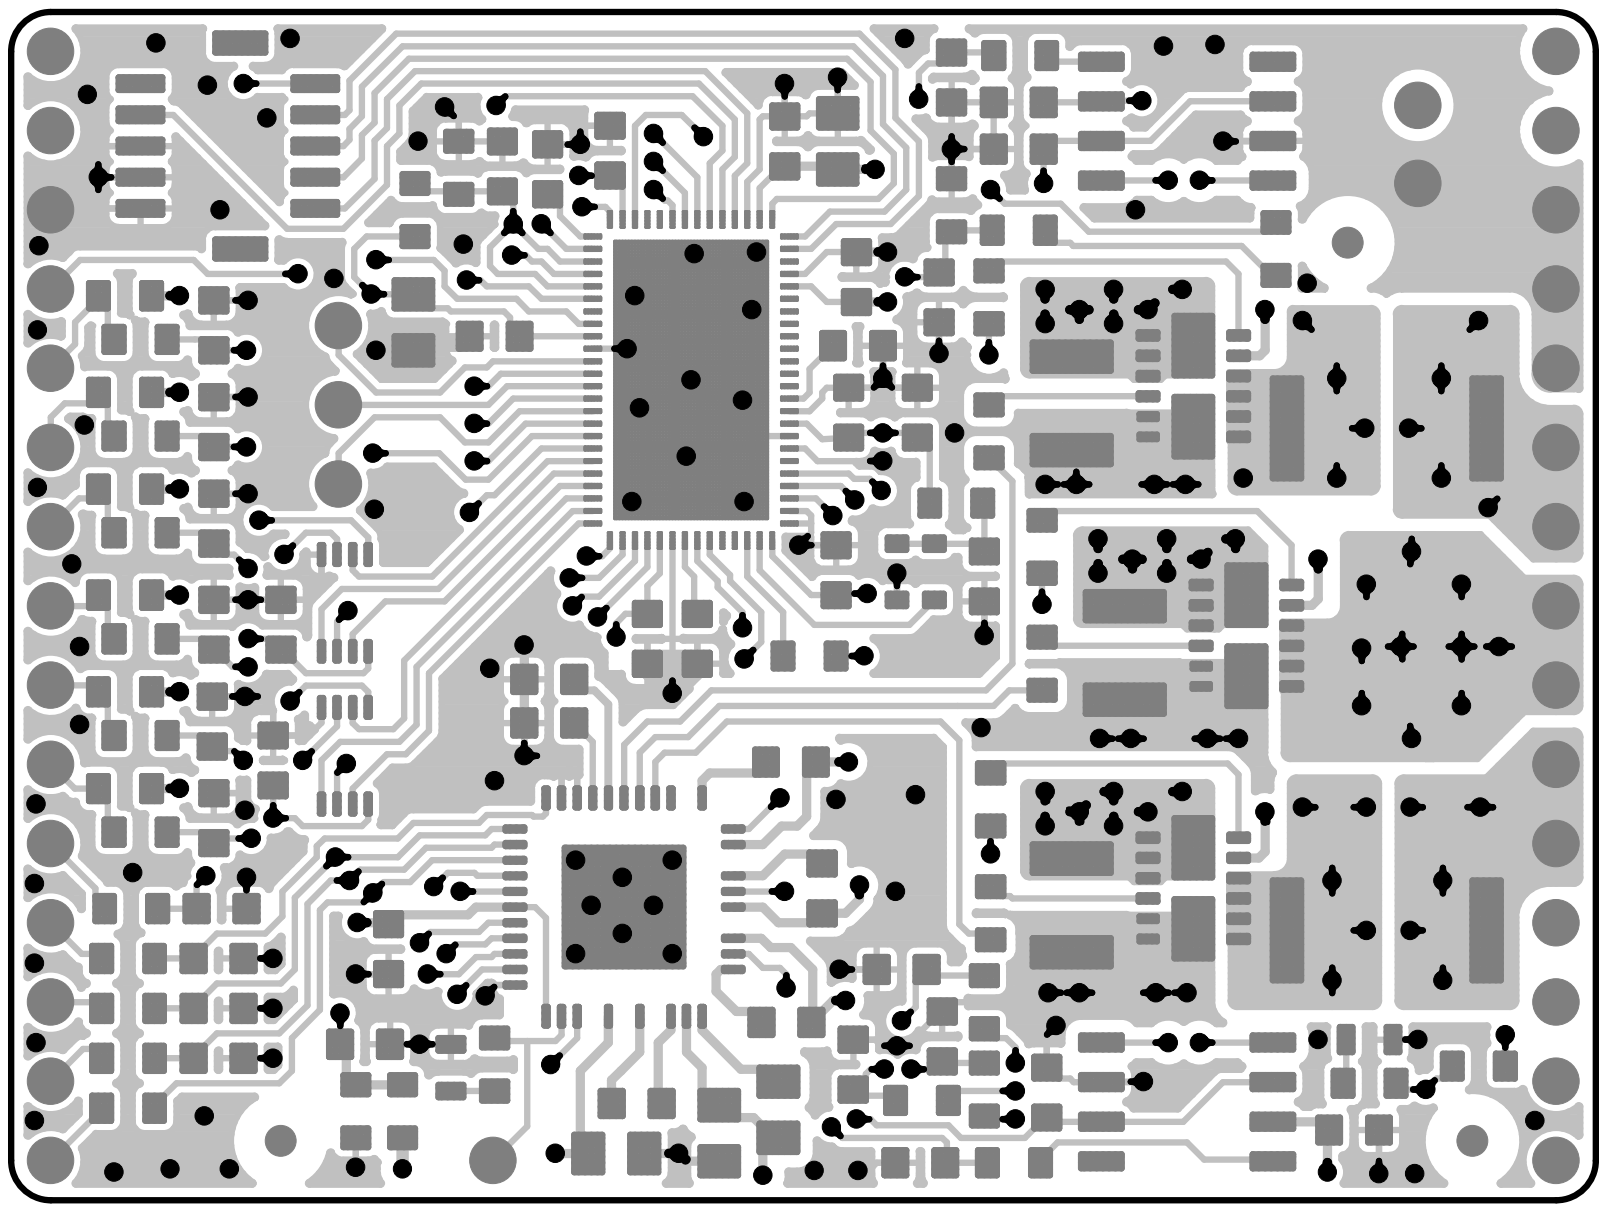
[picture p23: page 1]
