ThoMint/modFOC/DesignGuide/TMC4671Bob/PDF/Layers/L2.pdf

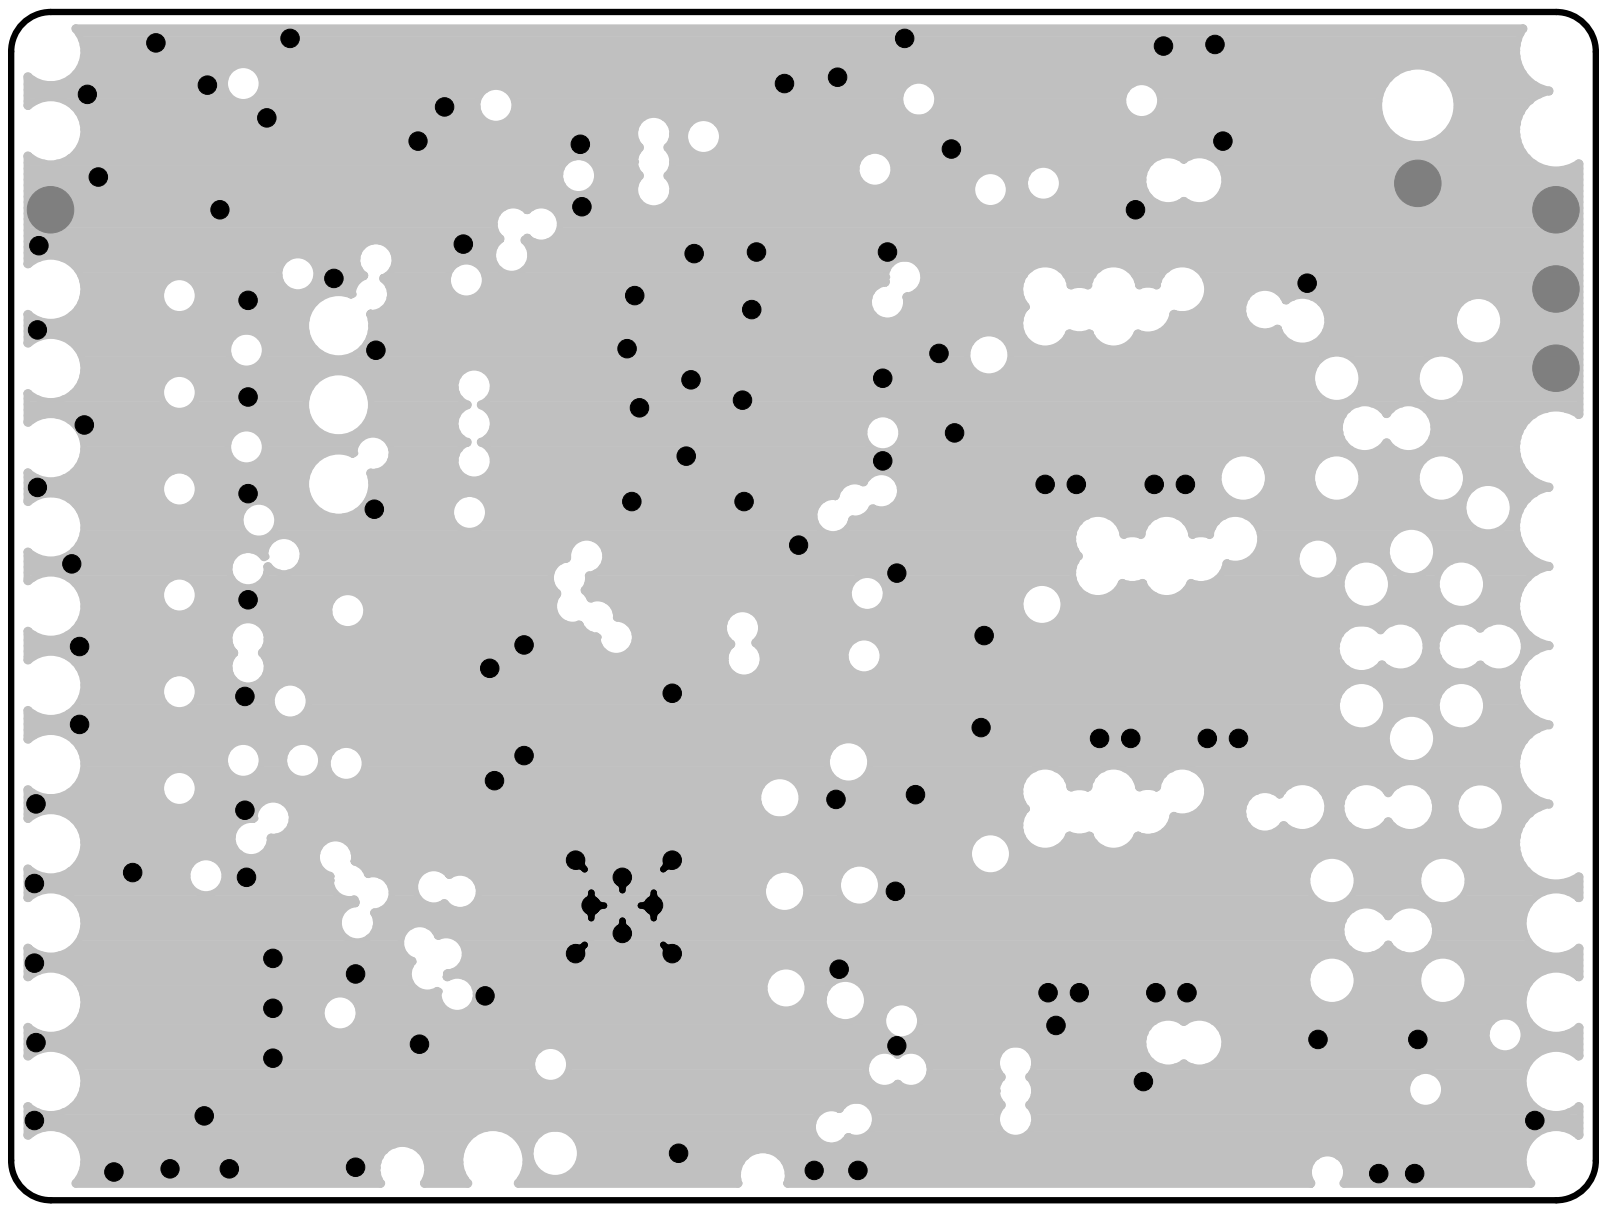
[picture p24: page 1]
