ThoMint/modFOC/DesignGuide/TMC4671Bob/PDF/Layers/L3.pdf

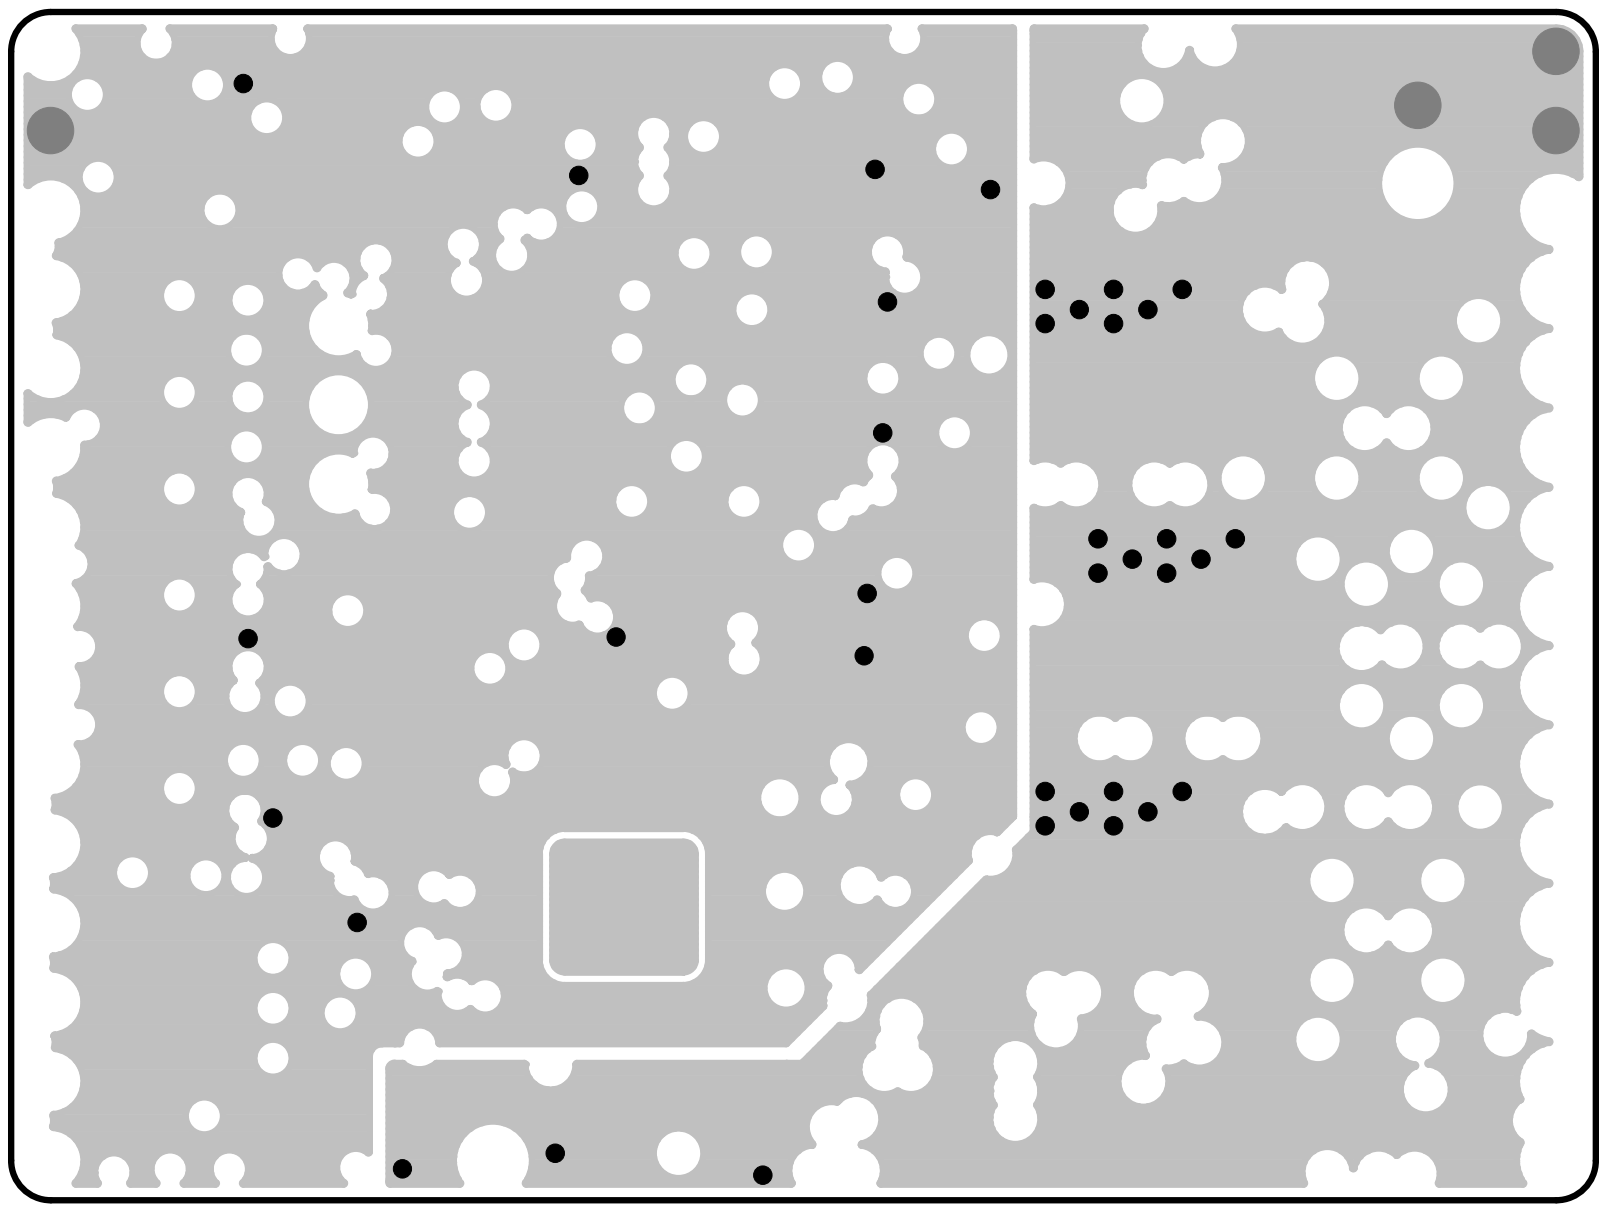
[picture p25: page 1]
