ThoMint/modFOC/DesignGuide/TMC4671Bob/PDF/Layers/L4.pdf

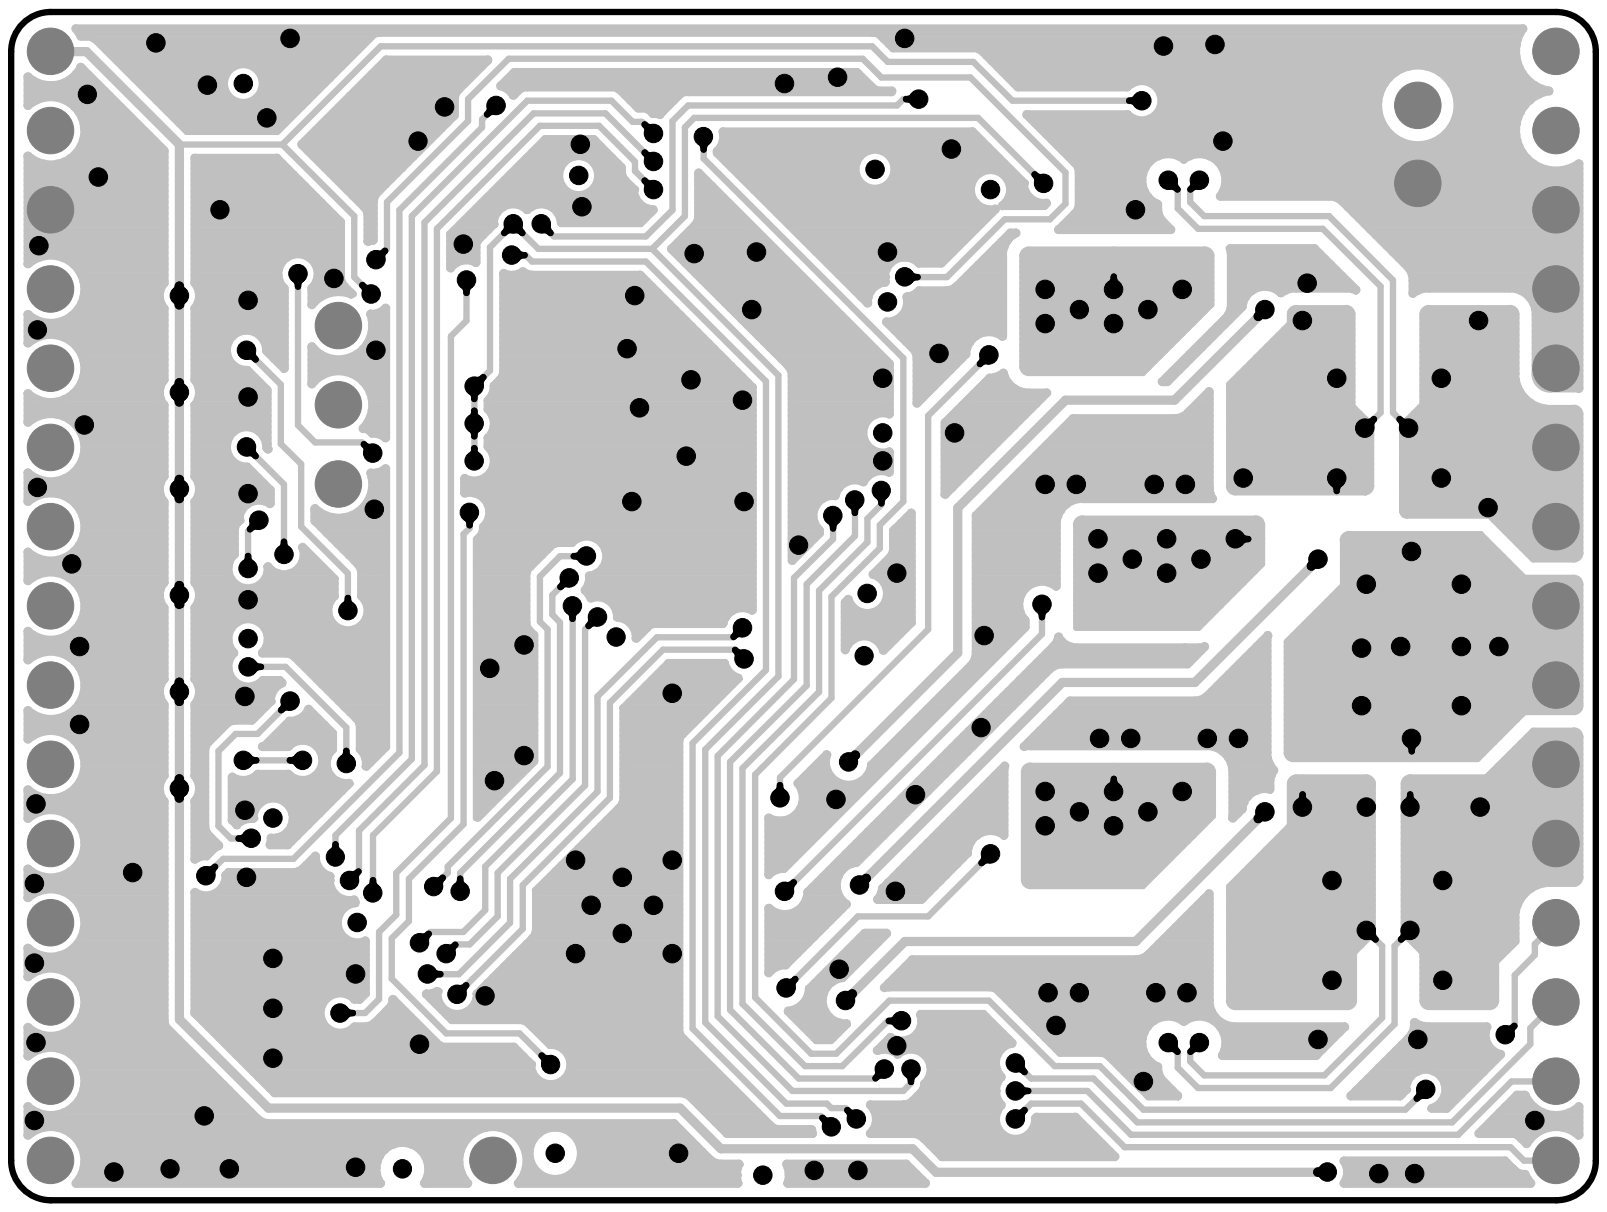
[picture p26: page 1]
