ThoMint/modFOC/DesignGuide/TMC4671Bob/PDF/PCB PDF/PCB_Top.pdf

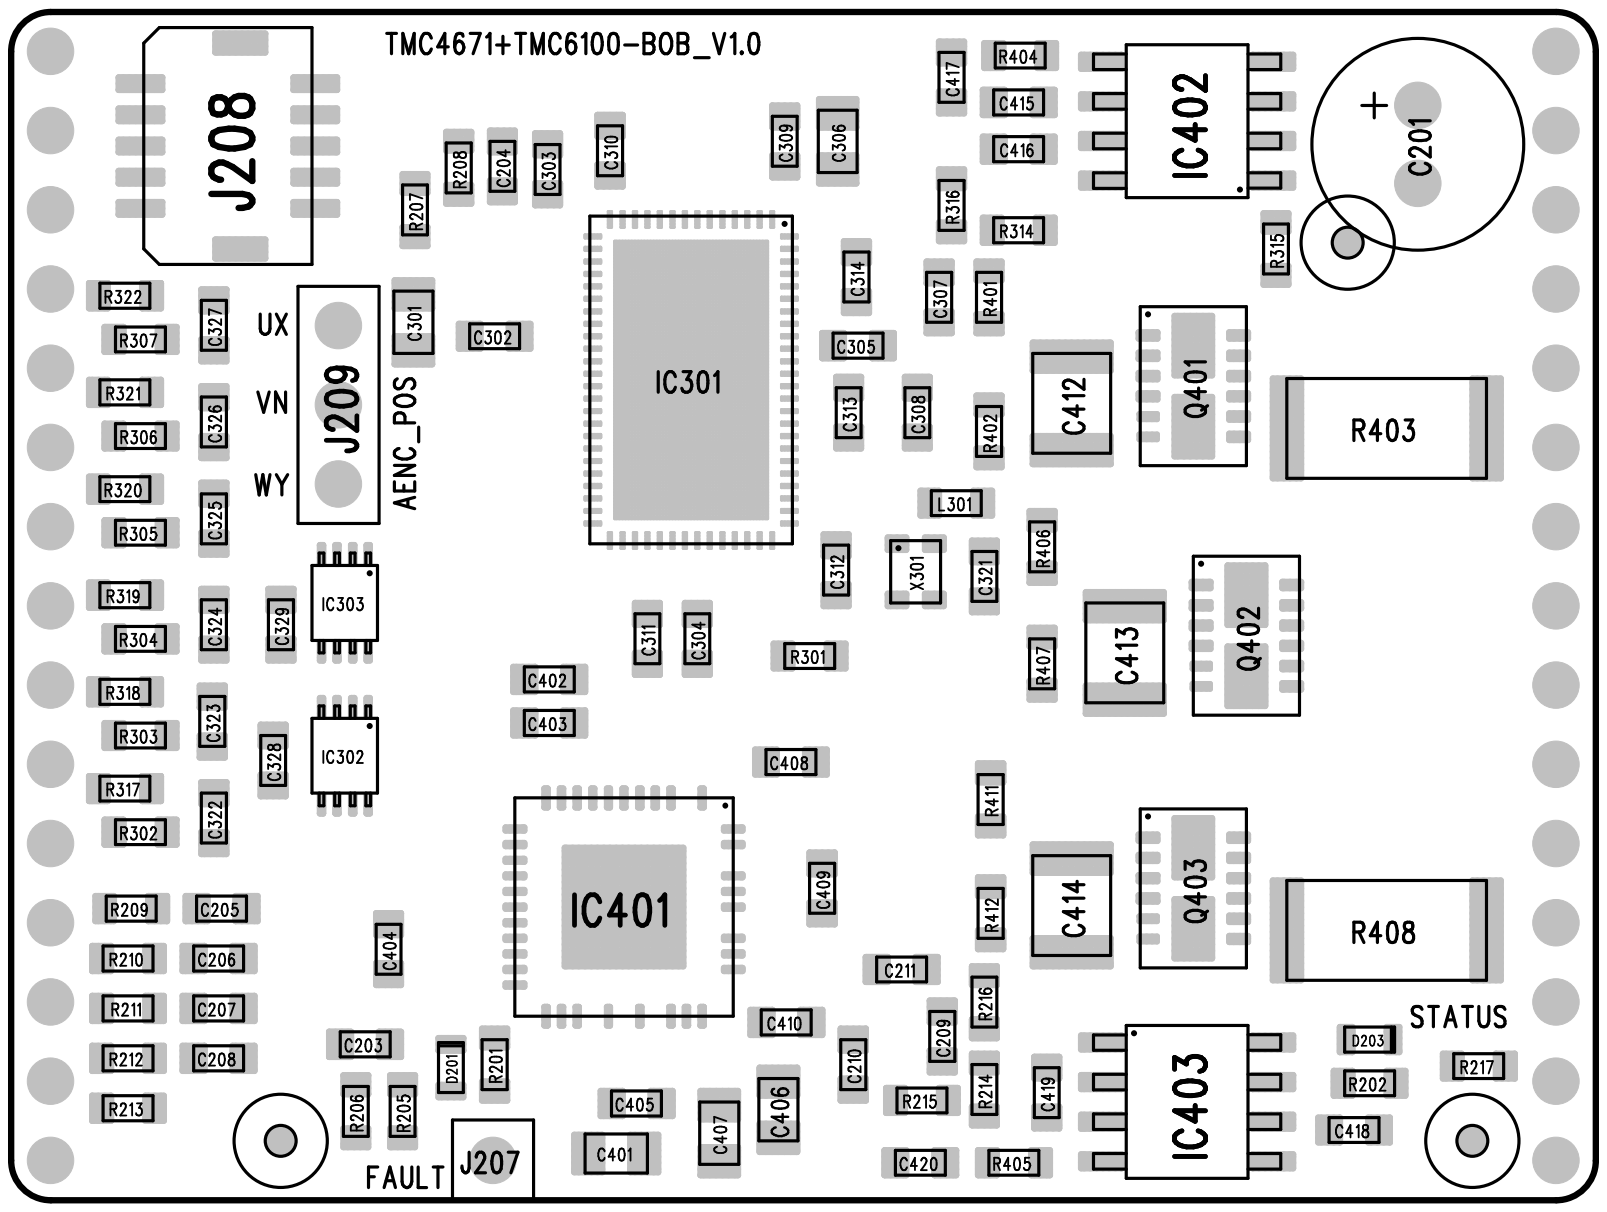
[picture p27: page 1]
