ThoMint/modFOC/(list of files, drawings)

Other design files:
DesignGuide/TMC4671Bob/CAD/ProjectBackup/TMC4671+TMC6100-BOB_V10_before filter import.pcb
DesignGuide/TMC4671Bob/CAD/TMC4671+TMC6100-BOB_V10.pcb
DesignGuide/TMC4671Eval/CAD/[1]_InterfaceConnectors.SchDoc
DesignGuide/TMC4671Eval/CAD/[2]_Communication_Inputs.SchDoc
DesignGuide/TMC4671Eval/CAD/[3]_Output_Feedback.SchDoc
DesignGuide/TMC4671Eval/CAD/[4]_Output_Feedback_2.SchDoc
DesignGuide/TMC4671Eval/CAD/[5]_Analog_input_filters.SchDoc
DesignGuide/TMC4671Eval/CAD/[6]_PSU.SchDoc
DesignGuide/TMC4671Eval/CAD/ChangeLog.SchDoc
DesignGuide/TMC4671Eval/CAD/TMC4671-EVAL_V1_2.PcbLib
DesignGuide/TMC4671Eval/CAD/TMC4671-EVAL_V1_2.PrjPcb
DesignGuide/TMC4671Eval/CAD/TMC4671-EVAL_V1_2.SchDoc
DesignGuide/TMC4671Eval/CAD/TMC4671-EVAL_V1_2.SchLib
Hardware/AltLibs/PcbLib1.PcbLib
Hardware/AltLibs/RcMPPTLib.PcbLib
Hardware/AltLibs/RcMPPTLib.SchLib
Hardware/AltLibs/Schlib1.SchLib
Hardware/MCU/modFOCMCU/modFOCMCU.PrjPcb
Hardware/modFOC-ESC/modFOC-ESC.PrjPcb
Hardware/modFOC-ESC/modFOC-Motion_Controller.SchDoc
Hardware/modFOC-ESC/modFOC-Powerstage.SchDoc
Hardware/modFOC-ESC/modFOC-Sensing.SchDoc
Hardware/modFOC-ESC/modFOC_ESC.PcbDoc
Hardware/modFOC-MCU/modFOC-IO.SchDoc
Hardware/modFOC-MCU/modFOC-MCU.PcbDoc
Hardware/modFOC-MCU/modFOC-MCU.PrjPcb
Hardware/modFOC-MCU/modFOC-MCU.SchDoc
Hardware/modFOC-MCU/modFOC-Power_Module.SchDoc
Hardware/modFOC-Panel/modFOC-Panel.PcbDoc
Hardware/modFOC-Panel/modFOC-Panel.PrjPcb
Hardware/modFOC/modFOC.PrjPcb
