ThoMint/modFOC/Software/Core/Src/main.c

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
/* Includes ------------------------------------------------------------------*/
#include "main.h"
#include "spi.h"
#include "usb_device.h"
#include "gpio.h"

/* USER CODE BEGIN Includes */
#include "usbd_cdc_if.h"
#include "TMC4671.h"
#include "TMC4671_Constants.h"
#include "TMCL.h"
#include "ESC.h"
/* USER CODE END Includes */


/* USER CODE BEGIN PV */
_Bool RUN_MODE;	//0-Normal	1-TMCL
/* USER CODE END PV */

void SystemClock_Config(void);
/* USER CODE BEGIN PFP */
uint8_t tmc4671_readwriteByte(uint8_t motor, uint8_t data, uint8_t lastTransfer);
/* USER CODE END PFP */

/* USER CODE BEGIN 0 */
int _write(int file, char *ptr, int len)
{
	for (int i = 0; i < len; i++)
	{
		ITM_SendChar(*ptr++);
	}
	return len;
}
/* USER CODE END 0 */

/**
 * @brief  The application entry point.
 * @retval int
 */
int main(void)
{
	/* MCU Configuration--------------------------------------------------------*/

	/* Reset of all peripherals, Initializes the Flash interface and the Systick. */
	HAL_Init();

	/* Configure the system clock */
	SystemClock_Config();

	/* Initialize all configured peripherals */
	MX_GPIO_Init();
	MX_SPI2_Init();
	MX_USB_Device_Init();
	/* USER CODE BEGIN 2 */
	//Indicate Initialization
	HAL_GPIO_WritePin(LED_GPIO_Port, LED1_Pin | LED2_Pin | LED3_Pin, GPIO_PIN_SET);
	//Wait for TMC boot
	HAL_Delay(500);
	//Determine Run Mode
	RUN_MODE = HAL_GPIO_ReadPin(AUX_SW_GPIO_Port, AUX_SW_Pin);
	//Setup GPIOs and calibrate ADC offset
	tmc4671_disablePWM(DEFAULT_MC);

	//Wait for sufficient supply voltage
	while (getVM(DEFAULT_MC) < 65)
		;

	//Calibrate the shunt amplifiers of the default motion controller
	calibrateShuntAmplifier(DEFAULT_MC);

	//Init the default motion controller
	if (RUN_MODE == RM_ESC)
	{
		initMotionController(DEFAULT_MC);
	}

	//Indicate Initialization finished
	HAL_GPIO_WritePin(LED_GPIO_Port, LED1_Pin | LED2_Pin | LED3_Pin, GPIO_PIN_RESET);
	/* USER CODE END 2 */

	/* Infinite loop */
	/* USER CODE BEGIN WHILE */
	while (1)
	{
		if (RUN_MODE == RM_TMCL)
		{
			tmcl_processCommand();
		}
		if (RUN_MODE == RM_ESC)
		{
			tmc4671_writeInt(DEFAULT_MC, TMC4671_MODE_RAMP_MODE_MOTION, 0x00000001);
			tmc4671_writeInt(DEFAULT_MC, TMC4671_PID_TORQUE_FLUX_TARGET, 0x03E80000);
		}
		/*
		 if (getVM(DEFAULT_MC) < 65)
		 {
		 HAL_GPIO_WritePin(LED_GPIO_Port, LED1_Pin | LED2_Pin | LED3_Pin, GPIO_PIN_SET);
		 tmc4671_writeInt(DEFAULT_MC, TMC4671_PID_TORQUE_FLUX_TARGET, 0x00000000);
		 if (RUN_MODE == RM_ESC)
		 {
		 tmc4671_disablePWM(DEFAULT_MC);
		 while (getVM(DEFAULT_MC) < 65);
		 calibrateShuntAmplifier(DEFAULT_MC);
		 initMotionController(DEFAULT_MC);
		 }
		 HAL_Delay(500);
		 HAL_GPIO_WritePin(LED_GPIO_Port, LED1_Pin | LED2_Pin | LED3_Pin, GPIO_PIN_RESET);
		 }
		 */
		/* USER CODE END WHILE */

		/* USER CODE BEGIN 3 */
	}
	/* USER CODE END 3 */
}

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
/* USER CODE BEGIN 4 */
uint8_t tmc4671_readwriteByte(uint8_t motor, uint8_t data, uint8_t lastTransfer)
{
	uint8_t buffer;

	HAL_GPIO_WritePin(CS0_GPIO_Port, (CS2_Pin * ((motor >> 2) & 0x01)) | (CS1_Pin * ((motor >> 1) & 0x01)) | (CS0_Pin * ((motor >> 0) & 0x01)), GPIO_PIN_SET);

	HAL_SPI_TransmitReceive(&hspi2, &data, &buffer, 1, 100);

	if (lastTransfer)
	{
		HAL_GPIO_WritePin(CS0_GPIO_Port, (CS2_Pin * ((motor >> 2) & 0x01)) | (CS1_Pin * ((motor >> 1) & 0x01)) | (CS0_Pin * ((motor >> 0) & 0x01)), GPIO_PIN_RESET);
	}

	return buffer;
}
/* USER CODE END 4 */
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
