ThoMint/modFOC/Software/Core/Inc/main.h

#define LED1_Pin GPIO_PIN_0
#define LED1_GPIO_Port GPIOC
#define LED2_Pin GPIO_PIN_1
#define LED2_GPIO_Port GPIOC
#define LED3_Pin GPIO_PIN_2
#define LED3_GPIO_Port GPIOC
#define CS0_Pin GPIO_PIN_6
#define CS0_GPIO_Port GPIOC
#define CS1_Pin GPIO_PIN_7
#define CS1_GPIO_Port GPIOC
#define CS2_Pin GPIO_PIN_8
#define CS2_GPIO_Port GPIOC
#define T_SWDIO_Pin GPIO_PIN_13
#define T_SWDIO_GPIO_Port GPIOA
#define T_SWCLK_Pin GPIO_PIN_14
#define T_SWCLK_GPIO_Port GPIOA
#define T_SWO_Pin GPIO_PIN_3
#define T_SWO_GPIO_Port GPIOB
#define AUX_SW_Pin GPIO_PIN_9
#define AUX_SW_GPIO_Port GPIOB
#define RM_TMCL 1
#define RM_ESC 0
#define LED_GPIO_Port GPIOC
