ThoMint/modFOC/DesignGuide/TMC4671Bob/CAD/borders.ini

[SYMBOLS]
A2SHEETL=Borders:TMC_A2_sheet.1
A2SHEETL1=Borders:TMC_A2_sheet.1
[ZONE A2SHEETL]
OFFSETLEFT=0
OFFSETRIGHT=0
OFFSETTOP=0
OFFSETBOTTOM=0
VERTNUMBER=5
HORZNUMBER=7
VERTLABELING=1
HORZLABELING=2
[ATTRIBUTES]
APPROVEDBY=BD
DESIGNEDBY=HH
RELEASEDATE=2019-11-28
REVISION=1.0
SHEETTITLE=?
[ANNOTATIONS]
[DEFAULTS]
