ThoMint/modFOC/Software/TMC/ic/TMC4671/TMC4671_Constants.h

/*
 * TMC4671_Constants.h
 *
 *  Created on: 23.07.2018
 *      Author: LK
 */

#ifndef TMC_IC_TMC4671_TMC4671_CONSTANTS_H_
#define TMC_IC_TMC4671_TMC4671_CONSTANTS_H_

#include "helpers/Constants.h"

#define TMC4671_STATUS_FLAGS_REF_MASK   0x00700000
#define TMC4671_STATUS_FLAGS_REF_SHIFT  20

#endif /* TMC_IC_TMC4671_TMC4671_CONSTANTS_H_ */
