ThoMint/modFOC/(commit log)

2020-09-16 Added DesignGuide
    [BOM_TMC4671-EVAL_V1.2.xls, ChangeLog.SchDoc, ProjectBackup.cfg, TMC4671+TMC6100-BOB_V10 - BOM.xlsx, TMC4671+TMC6100-BOB_V10 - Pick and Place.xlsx, TMC4671+TMC6100-BOB_V10.pcb, TMC4671+TMC6100-BOB_V10_before filter import.pcb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]
2020-10-12 development of schematic
    [driverBoard.PcbDoc, driverBoard.PrjPcb, driverBoard.SchDoc]
2020-10-18 Libs added
    [PcbLib1.PcbLib, Schlib1.SchLib]
2020-10-18 Scematic dev
    [PcbLib1.PcbLib, Schlib1.SchLib, driverBoard.PrjPcb, driverBoard.SchDoc]
2020-10-23 added software
    added STM32CubeIDE project utilizing the Nucleo-32f334 board and the TMC4671 + TMC6100 BOB for evaluation purposes
2020-10-25 Schematic development
    [PcbLib1.PcbLib, Schlib1.SchLib, driverBoard.PcbDoc, driverBoard.SchDoc]
2021-01-09 startet developement of powerstage
    [PcbLib1.PcbLib, Schlib1.SchLib, modFOC-Measure_and_Auxilary.SchDoc, modFOC-Motion_Controller.SchDoc, modFOC-Powerstage.SchDoc, modFOC-Sensing.SchDoc, modFOC.PcbDoc, modFOC.PrjPcb]
2021-01-18 Power-stage developement
    [PcbLib1.PcbLib, Schlib1.SchLib, modFOC-Motion_Controller.SchDoc, modFOC-Powerstage.SchDoc, modFOC-Sensing.SchDoc, modFOC.PcbDoc, modFOC.PrjPcb, modFOC_ESC.PcbDoc]
2021-01-23 Added MCU
    [modFOC-5VSupply.SchDoc, modFOC-MCU.SchDoc, modFOC.PrjPcb]
2021-01-29 Schematic finalized
    [PcbLib1.PcbLib, Schlib1.SchLib, modFOC-Motion_Controller.SchDoc, modFOC-Powerstage.SchDoc, modFOC-Sensing.SchDoc, modFOC.PrjPcb, modFOC_ESC.PcbDoc]
2021-01-29 improved file branch
    [PcbLib1.PcbLib, Schlib1.SchLib, modFOC-5VSupply.SchDoc, modFOC-ESC.PrjPcb, modFOC-MCU.PrjPcb, modFOC-MCU.SchDoc, modFOC-Motion_Controller.SchDoc, modFOC-Powerstage.SchDoc]
2021-02-07 Routing of Driver/Powerstage PCB
    [PcbLib1.PcbLib, Schlib1.SchLib, modFOC-ESC.PrjPcb, modFOC-Motion_Controller.SchDoc, modFOC-Powerstage.SchDoc, modFOC-Sensing.SchDoc, modFOC_ESC.PcbDoc]
2021-02-08 PCB design
    [modFOC-ESC.PrjPcb, modFOC_ESC.PcbDoc]
2021-02-09 PCB updated
    [PcbLib1.PcbLib, modFOC_ESC.PcbDoc]
2021-02-09 updated MCU Board
    [RcMPPTLib.PcbLib, RcMPPTLib.SchLib, modFOC-5VSupply.SchDoc, modFOC-IO.SchDoc, modFOC-MCU.PcbDoc, modFOC-MCU.PrjPcb, modFOC-MCU.SchDoc, modFOC-Power_Module.SchDoc]
2021-02-09 updated PCB
    [modFOC-Powerstage.SchDoc, modFOC_ESC.PcbDoc]
2021-02-11 developed MCU Board
    [modFOC-IO.SchDoc, modFOC-MCU.PcbDoc, modFOC-MCU.PrjPcb, modFOC-Power_Module.SchDoc]
2021-02-12 routed Power Module
    [modFOC-MCU.PcbDoc]
2021-02-15 added features and routed PCB
    [PcbLib1.PcbLib, Schlib1.SchLib, modFOC-ESC.PrjPcb, modFOC-Motion_Controller.SchDoc, modFOC-Powerstage.SchDoc, modFOC_ESC.PcbDoc]
2021-02-22 routed PCB
    [PcbLib1.PcbLib, Schlib1.SchLib, modFOC-ESC.PrjPcb, modFOC-Motion_Controller.SchDoc, modFOC-Powerstage.SchDoc, modFOC-Sensing.SchDoc, modFOC_ESC.PcbDoc]
2021-02-25 rooted PCB
    [PcbLib1.PcbLib, Schlib1.SchLib, modFOC-ESC.PrjPcb, modFOC-Powerstage.SchDoc, modFOC_ESC.PcbDoc]
2021-03-04 migrated CubeMX Project
    [RcMPPTLib.PcbLib, modFOC-IO.SchDoc, modFOC-MCU.PcbDoc, modFOC-MCU.PrjPcb, modFOC-MCU.SchDoc]
2021-03-07 routed PCB
    This reverts commit c65a0e6950c803c6a30fa2dae71aa08f96d48dcb.
    [PcbLib1.PcbLib, Schlib1.SchLib, modFOC-ESC.PrjPcb, modFOC-Motion_Controller.SchDoc, modFOC_ESC.PcbDoc]
2021-03-15 assigned CubeMX Pins, routed PCB
    [modFOC-IO.SchDoc, modFOC-MCU.PcbDoc, modFOC-MCU.PrjPcb]
2021-03-15 added Multiboard Assembly
2021-03-17 edited MBA, changed SMT32 Pinout
    [modFOC-IO.SchDoc, modFOC-MCU.PcbDoc, modFOC-MCU.SchDoc]
2021-03-19 added Design Guide, routed PCB
    [modFOC-MCU.PcbDoc]
2021-04-05 finished Controller-PCB routing
    [RcMPPTLib.PcbLib, RcMPPTLib.SchLib, modFOC-IO.SchDoc, modFOC-MCU.PcbDoc, modFOC-MCU.SchDoc, modFOC-Power_Module.SchDoc]
2021-04-06 finished version 1.0
    [PcbLib1.PcbLib, modFOC-ESC.PrjPcb, modFOC-ESC.xlsx, modFOC-IO.SchDoc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]
2021-04-06 added PCB-Panel for Stencil
    [modFOC-Panel.GBL, modFOC-Panel.GBO, modFOC-Panel.GBP, modFOC-Panel.GBS, modFOC-Panel.GM1, modFOC-Panel.GTL, modFOC-Panel.GTO, modFOC-Panel.GTP]
2021-04-06 updated BOM
    [Schlib1.SchLib, modFOC-ESC.PrjPcb, modFOC-ESC.xlsx, modFOC-Motion_Controller.SchDoc]
2021-06-03 updated firmware, added design guide
    [AlternatePartsModFOC.xlsx]
