ThoMint/modFOC/(notices)

Notices in the files:
Software/Core/Src/main.c:
© Copyright (c) 2021 STMicroelectronics.
All rights reserved.
This software component is licensed by ST under Ultimate Liberty license
Software/Core/Inc/main.h:
(C) COPYRIGHT STMicroelectronics *****END OF FILE
